makerspace-wi/Entry_System/README.md

# Entry_System
### RFID Tag controlled Entry Door Control System

Neu November 2021: RFID-Lesegerät mit Tastatur für erweiterte Sicherheit und Funktionalität

 

##### Prozessor Typ: Arduino Mini Pro 5 Volt
##### Components:
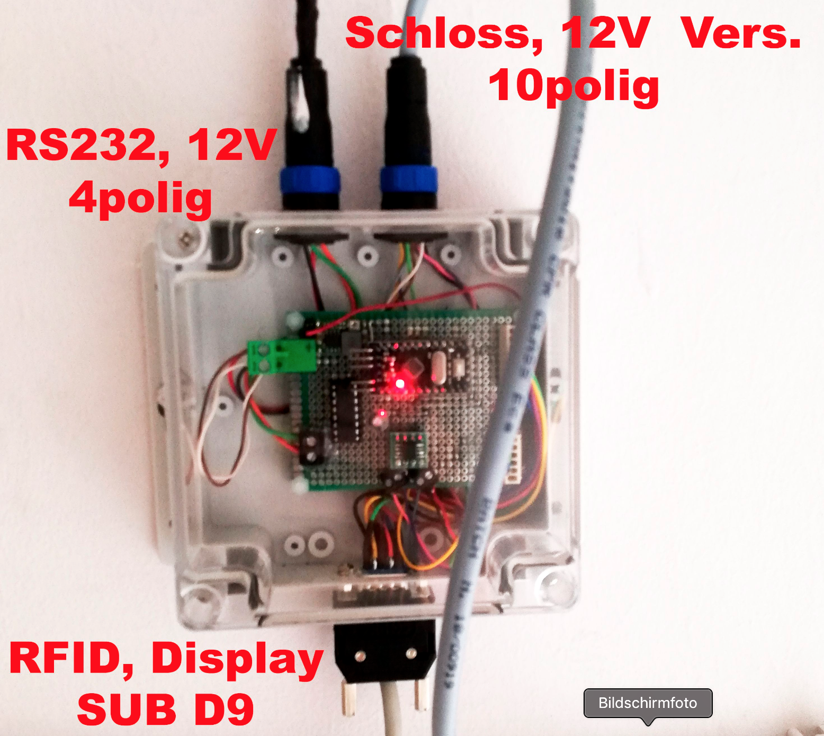
[picture p1: images/Screenshot 2018-11-06 08.17.54.png]
- Front End Controller Arduino Mini Pro<br><br> <br>
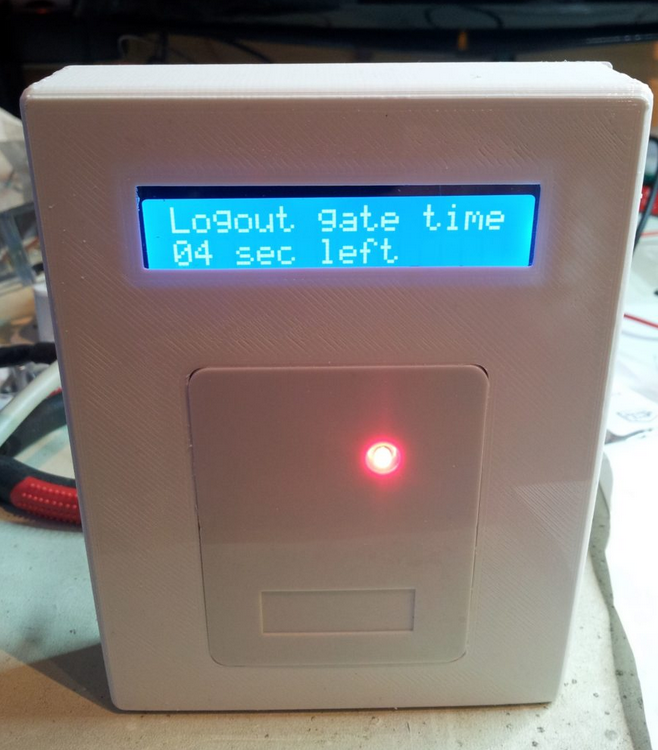
[picture p2: images/Screenshot 2018-11-06 09.19.30.png]
- RFID-Reader and Display Unit (mounted outside beside the entry door)<br><br>
- new from Nov/Dec 2021 on:<br>
<br> <br>
- 12 VDC power supply with rechargeable battery (12V 20Ah)
- Raspberry Pi 3 located in Server room - connected via serial link <br>running SYMCON Automation Software & MySQL Databse
- KESO MOZY eco (Motorzylinder) 12VDC

##### Output Signals:
- unlock KESO Motorzylinder pulse
- unlock KESO Motorzylinder permanantely
- I2C Signal to Display Unit

##### Input Signals:
- Wiegand Bus (D0 & D1) from RFID-Card reader
- KESO MOZY 'UNLOCK' signal
- 'ring' signal from Siedle Door Station
