makerspace-wi/Entry_System/doc/GeräteListe.pdf

Geräte | | fertig | | | | | RFID | Controller | | Netzteil
CNC1 [Klaus] | MA01 | Ja | Ja | 9.8.1 | ≥15,00mm | xBee | RC522 | mini | flow | 1PH
CNC3 [Klaus, …] | MA02 | Ja | - | 9.8.5 | ≥15,00mm | xBee | RC523 | mini | Ja | 1PH
Laserengraver | MA03 | Ja | Ja | 9.6.x | ≥12,00mm | xBee | RC522 | mini | nein | 1PH
CNC2 Hacks, CNC14 [Michael] | MA04 | Ja | Ja | 9.6.x | ≥12,00mm | xBee | RC522 | mini | (Ja) | 1PH
Kappsäge Holz | MA05 | Ja | Ja | 9.8.1 | ≥12,00mm | xBee | RC522 | mini | ja | 1PH
Formatkreissäge Holz | MA06 | Ja | Ja | 9.8.1 | ≥15,00mm | xBee | RC522 | mini | ja | 3PH
Bandsäge Holz | MA07 | Ja | Ja | 9.8.1 | ≥15,00mm | xBee | RC522 | mini | ja | 3PH
Dickenhobel Holz | MA08 | Ja | Ja | 8.8.1 | ≥15,00mm | xBee | RC522 | mini | ja | 3PH
Schleifer Holz | MA09 | Ja | Ja | 9.8.1 | ≥15,00mm | xBee | RC522 | mini | ja | 3PH
Blauer Laser | MA10 | Ja | Ja | 9.6.x | ≥5,00mm | xBee | RC522 | mini | (Ja) | 1PH
Drechselbank 1 | MA11 | Ja | Ja | 9.8.1 | ≥12,00mm | xBee | RC522 | mini | nein | 1PH
Drechselbank 2 | MA12 | Ja | Ja | 9.8.1 | ≥15,00mm | xBee | RC522 | mini | nein | 1PH
Kappsäge Metall | MA13 | Ja | Ja | 9.7.3 | ≥15,00mm | xBee | RC522 | mini | nein | 1PH
Frästisch Holz | MA14 | Ja | Ja | 9.6.x | ≥12,00mm | xBee | RC522 | mini | ja | 1PH
Drehbank Metall | MA15 | Ja | Ja | 9.6.x | ≥12,00mm | xBee | RC522 | mini | nein | 3PH
Ständerbohrmaschine Metall | MA16 | Ja | Ja | 9.8.1 | ≥15,00mm | xBee | RC522 | mini | nein | 1PH
Dekupiersäge | MA17 | Ja | Ja | 9.8.1 | ≥15,00mm | xBee | RC522 | mini | nein | 1PH
Sandstrahl Kompessor | MA18 | Ja | Ja | 9.8.1 | ≥15,00mm | xBee | RC522 | mini | ja | 3PH
Drehbank Üben | MA19 | Ja | Ja | 9.8.1 | ≥15,00mm | xBee | RC523 | mini | nein | 1PH
3D-Druck 1 | MA20 | - | - | 9.8.5 | ≥15,00mm | xBee | RC524 | mini | nein | 1PH | SSR
3D-Druck 2 | MA21 | - | - | 9.8.5 | ≥15,00mm | xBee | RC524 | mini | nein | 1PH | SSR
ToolsLocker1 | TOL1 | Ja | Ja | 1.0.0 | ≥20,00mm | xBee | RC522 | mini | nein | 1PH | SSR
ToolsLocker2 | TOL2 | Ja | Ja | 1.2.0 | ≥15,00mm | xBee | RC522 | mini | nein | 1PH | SSR
Garage | GADO | Ja | Ja | 1.5.0 | ≥10,00mm | xBee | PN532 | mini | nein | 1PH | SSR

Extra Teile (EntrySystem)
Entry_System | - | Ja | Ja | 3.6.0 | - | rs232 | Wiegand | mini | - | 12V (Bat.) | -
DCDC_RS232_RASPI | - | Ja | Ja | - | - | rs232 | - | - | - | 12V (Bat.) | -
RFIDServerraum | ? | Ja | Ja | ? | - | rs232 | Wiegand | nano | - | 12V (Bat.) | -
Vereinsdisplay | DISP | Ja | Ja | 1.2.1 | - | xBee | - | mini | - | 12V→24V | -
PrecenseDetector_Clock | SENSOR | Ja | Ja | 1.2.0 | - | xBee | - | mini | - | 1PH | -
Heizung | | Ja | Ja | ? | - | WLAN | - | ESP8266 | - | 5V St.NT | -
BewegungFlur | | Ja | Ja | ? | - | WLAN | - | ESP8266 | - | 5V St.NT | -
KlingelLight | | Ja | Ja | ? | - | WLAN | - | ESP8266 | - | 5V St.NT | -
Metallraum BewKliTemp | | Ja | Ja | ? | - | WLAN | - | ESP8266 | - | 5V St.NT | -
Gesamt Ja | | 31 | 30 | | Abst.: 22 | xBee: 29 | RFID: 21 | Mini: 31 | Strom=9 | 1PH=20 | SSR=18
Gesamt in Arbeit
| | | | | | WLan: 4 | WieG: 2 | Nano: 1 | flow=1 | 3PH=6 | REL=5
Maschinen-Nr. | In BetriebSoftwareVersionRFID AbstandKommuni-Kation | Strom-Messung | SSR, Relais
| | | SSR SSR SSR SSR Relais SSR SSR SSR SSR SSR SSR Relais Relais Relais Schütz Relais SSR Schütz SSR
