makerspace-wi/Entry_System/doc/Anschluss Display.jpg

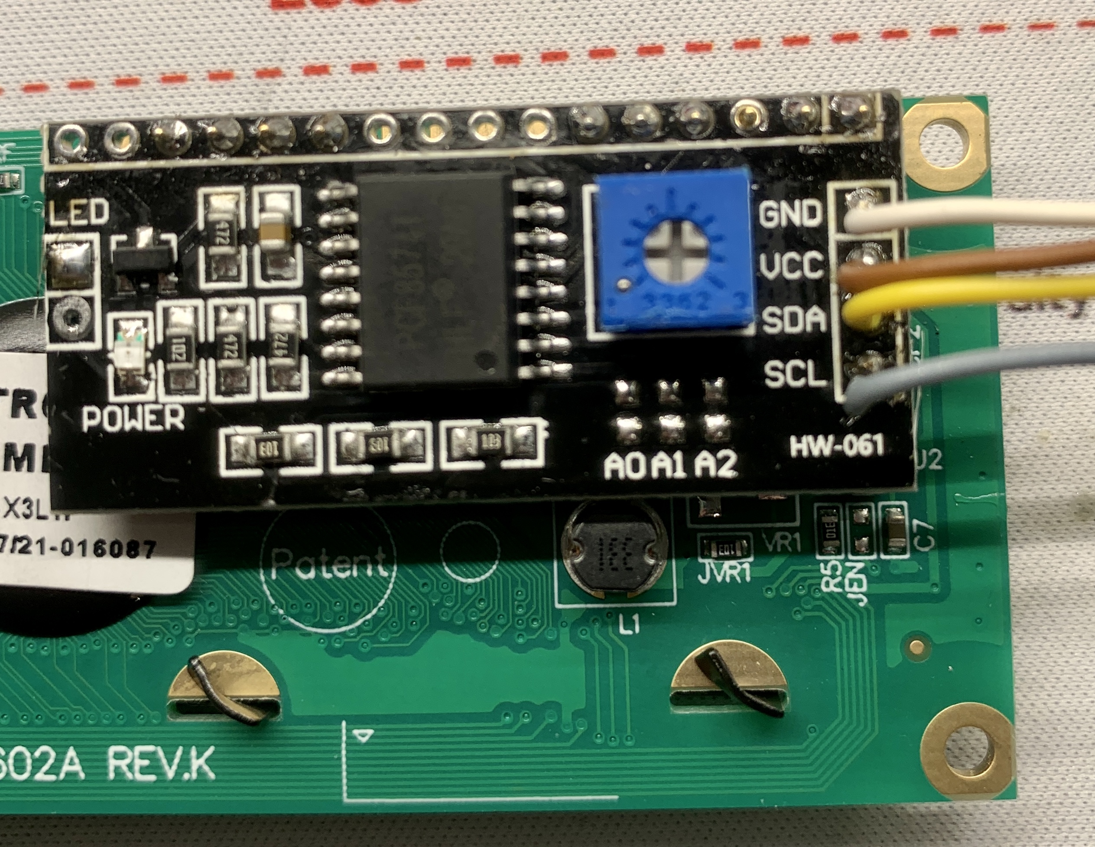
doc/Anschluss Display.jpg
