makerspace-wi/Entry_System/doc/Anschluss New Reader.jpg

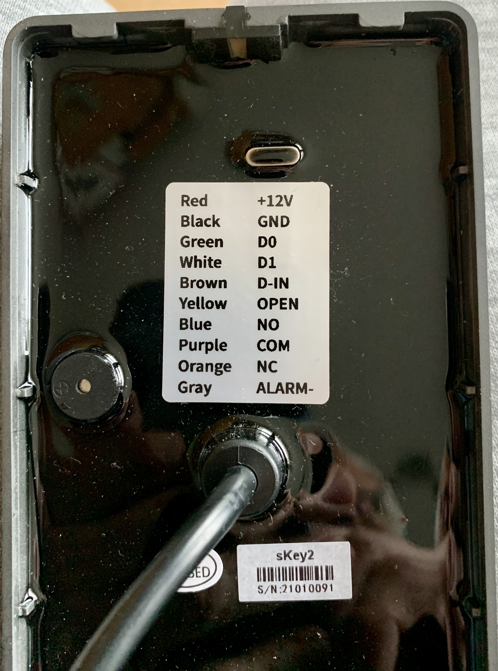
doc/Anschluss New Reader.jpg
