makerspace-wi/Entry_System/doc/GeräteListe.xls

Geräte | Maschinen- Nr. | fertig | In Betrieb | Software Version | RFID Abstand | Kommuni- Kation | RFID | Controller | Strom- Messung | Netzteil | SSR, Relais | ist vorhanden (komplett für PCBs) |  |  |  |  |  |  |  |  |  |  |  | Bemerkung |  | Preise
 |  |  |  |  |  |  |  |  |  |  |  | PCB Display | Relais | Display | RFID | Taster LED | PCB Controller | xBee | Taster RES | Gehäuse | PCB Netzteil | Netzteil | Gehäuse |  |  | RFID | NT | Summe | Erhalten
CNC1 [Klaus] | MA01 | Ja | Ja | 9.8.1 | ≥15.00mm | xBee | RC522 | mini | flow | 1PH | SSR | ok | - | ok | ok | ok | ok | ok | - | - | ok | ok | - | Ja | =nötig oder vorhanden | #REF! | #REF! | #REF!
CNC3 [Klaus, …] | MA02 | Ja | - | 9.8.5 | ≥15.00mm | xBee | RC523 | mini | Ja | 1PH | SSR | ok | ok | ok | ok | ok | ok | ok | ok | ok | ok | - | -
Laserengraver | MA03 | Ja | Ja | 9.6.x | ≥12.00mm | xBee | RC522 | mini | nein | 1PH | SSR | ok | ok | ok | ok | ok | ok | ok | ok | ok | ok | ok | ok | f | =fehlt noch | #REF! | #REF! | #REF!
CNC2 Hacks, CNC14 [Michael] | MA04 | Ja | Ja | 9.6.x | ≥12.00mm | xBee | RC522 | mini | (Ja) | 1PH | SSR | ok | ok | ok | ok | ok | ok | ok | ok | ok | ok | ok | - | - | =nicht nötig oder andere Lösung | #REF! | #REF! | #REF!
Kappsäge Holz | MA05 | Ja | Ja | 9.8.1 | ≥12.00mm | xBee | RC522 | mini | ja | 1PH | Relais | ok | ok | ok | ok | ok | ok | ok | ok | ok | ok | ok | ok | OK | =fertig und zusammen gebaut | #REF! | #REF! | #REF! | 280.00 €
Formatkreissäge Holz | MA06 | Ja | Ja | 9.8.1 | ≥15.00mm | xBee | RC522 | mini | ja | 3PH | SSR | ok | ok | ok | ok | ok | ok | ok | ok | ok | ok | ok | ok |  |  | #REF! | #REF! | #REF!
Bandsäge Holz | MA07 | Ja | Ja | 9.8.1 | ≥15.00mm | xBee | RC522 | mini | ja | 3PH | SSR | ok | ok | ok | ok | ok | ok | ok | ok | ok | ok | ok | ok |  |  | #REF! | #REF! | #REF!
Dickenhobel Holz | MA08 | Ja | Ja | 8.8.1 | ≥15.00mm | xBee | RC522 | mini | ja | 3PH | SSR | ok | ok | ok | ok | ok | ok | ok | ok | ok | ok | ok | ok |  |  | #REF! | #REF! | #REF! | 268.00 €
Schleifer Holz | MA09 | Ja | Ja | 9.8.1 | ≥15.00mm | xBee | RC522 | mini | ja | 3PH | SSR | ok | ok | ok | ok | ok | ok | ok | ok | ok | ok | ok | ok |  |  | #REF! | #REF! | #REF!
Blauer Laser | MA10 | Ja | Ja | 9.6.x | ≥5.00mm | xBee | RC522 | mini | (Ja) | 1PH | SSR | ok | ok | ok | ok | ok | ok | ok | ok | ok | ok | ok | ok |  |  | #REF! | #REF! | #REF! | 505.00 €
Drechselbank 1 | MA11 | Ja | Ja | 9.8.1 | ≥12.00mm | xBee | RC522 | mini | nein | 1PH | SSR | ok | ok | ok | ok | ok | ok | ok | ok | ok | ok | ok | ok |  |  | #REF! | #REF! | #REF!
Drechselbank 2 | MA12 | Ja | Ja | 9.8.1 | ≥15.00mm | xBee | RC522 | mini | nein | 1PH | Relais | ok | ok | ok | ok | ok | ok | ok | ok | ok | ok | ok | ok |  |  | #REF! | #REF! | #REF!
Kappsäge Metall | MA13 | Ja | Ja | 9.7.3 | ≥15.00mm | xBee | RC522 | mini | nein | 1PH | Relais | ok | ok | ok | ok | ok | ok | ok | ok | ok | ok | ok | ok |  |  | #REF! | #REF! | #REF!
Frästisch Holz | MA14 | Ja | Ja | 9.6.x | ≥12.00mm | xBee | RC522 | mini | ja | 1PH | Relais | ok | ok | ok | ok | ok | ok | ok | ok | ok | ok | ok | ok |  |  | #REF! | #REF! | #REF!
Drehbank Metall | MA15 | Ja | Ja | 9.6.x | ≥12.00mm | xBee | RC522 | mini | nein | 3PH | Schütz | ok | ok | ok | ok | ok | ok | ok | ok | ok | ok | ok | ok |  |  | #REF! | #REF! | #REF!
Ständerbohrmaschine Metall | MA16 | Ja | Ja | 9.8.1 | ≥15.00mm | xBee | RC522 | mini | nein | 1PH | Relais | ok | ok | ok | ok | ok | ok | ok | ok | ok | ok | ok | - |  |  | #REF! | #REF! | #REF!
Dekupiersäge | MA17 | Ja | Ja | 9.8.1 | ≥15.00mm | xBee | RC522 | mini | nein | 1PH | SSR | ok | ok | ok | ok | ok | ok | ok | ok | ok | ok | ok | ok
Sandstrahl Kompessor | MA18 | Ja | Ja | 9.8.1 | ≥15.00mm | xBee | RC522 | mini | ja | 3PH | Schütz | ok | ok | ok | ok | ok | ok | ok | ok | ok | ok | ok | ok
Drehbank Üben | MA19 | Ja | Ja | 9.8.1 | ≥15.00mm | xBee | RC523 | mini | nein | 1PH | SSR | ok | ok | ok | ok | ok | ok | ok | ok | ok | ok | ok | ok
3D-Druck 1 | MA20 | - | - | 9.8.5 | ≥15.00mm | xBee | RC524 | mini | nein | 1PH | SSR | ok | ok | ok | ok | ok | ok | ok | ok | ok | ok | - | -
3D-Druck 2 | MA21 | - | - | 9.8.5 | ≥15.00mm | xBee | RC524 | mini | nein | 1PH | SSR | ok | ok | ??? | ok | ok | ok | ??? | ok | ok | ok | - | - |  |  | #REF! | ? | #REF!
ToolsLocker1 | TOL1 | Ja | Ja | 1.0.0 | ≥20.00mm | xBee | RC522 | mini | nein | 1PH | SSR | ok | ok | ok | ok | ok | ok | ok | ok | ok | ok | ok | - |  |  | #REF! | ? | #REF!
ToolsLocker2 | TOL2 | Ja | Ja | 1.2.0 | ≥15.00mm | xBee | RC522 | mini | nein | 1PH | SSR | ok | ok | ok | ok | ok | ok | ok | ok | ok | ok | ok | -
Garage | GADO | Ja | Ja | 1.5.0 | ≥10.00mm | xBee | PN532 | mini | nein | 1PH | SSR | ok | ok | ok | ok | ok | ok | ok | ok | f | ok | ok | -
Extra Teile (EntrySystem)
Entry_System | - | Ja | Ja | 3.6.0 | - | rs232 | Wiegand | mini | - | 12V (Bat.) | - |  |  |  |  |  |  |  |  | ok
DCDC_RS232_RASPI | - | Ja | Ja | - | - | rs232 | - | - | - | 12V (Bat.) | -
RFIDServerraum | ? | Ja | Ja | ? | - | rs232 | Wiegand | nano | - | 12V (Bat.) | - |  |  |  |  |  |  |  |  | ok
Vereinsdisplay | DISP | Ja | Ja | 1.2.1 | - | xBee | - | mini | - | 12V→24V | - |  |  |  |  |  | ok | ok |  |  | ok | Step U&D
PrecenseDetector_Clock | SENSOR | Ja | Ja | 1.2.0 | - | xBee | - | mini | - | 1PH | - |  |  |  |  |  | ok | ok |  | ok |  | Step D | -
Heizung |  | Ja | Ja | ? | - | WLAN | - | ESP8266 | - | 5V St.NT | -
BewegungFlur |  | Ja | Ja | ? | - | WLAN | - | ESP8266 | - | 5V St.NT | -
KlingelLight |  | Ja | Ja | ? | - | WLAN | - | ESP8266 | - | 5V St.NT | -
Metallraum BewKliTemp |  | Ja | Ja | ? | - | WLAN | - | ESP8266 | - | 5V St.NT | -
Gesamt Ja |  | 31 | 30 |  | 0 | 0 | 0 | 0 | 0 | 0 | 0 | 0 | 0 | 0 | 0 |  | 0 | 0 |  | 0 | 0 | 0 | 0
Gesamt in Arbeit | ab Spalte M |  |  |  |  | 0 | 0 | 0 | 0 | 0 | 0 | 0 | 0 | 0 | 0 |  | 0 | 0 |  | 0 | 0 | 0 | 0 |  |  |  |  | #N/A | 1053.00 €
Gesamt unterwegs |  |  |  |  |  | 0 |  | 0 |  | 0 | 0 | 0 | 0 | 0 | 0 |  | 0 | 0 |  | 1 | 0 | 0 | 0 |  |  |  |  | #REF!
Gesamt fertig |  |  |  |  |  |  |  |  |  | 0 |  | 25 | 24 | 23 | 25 |  | 27 | 25 |  | 26 | 26 | 21 | 15 |  |  |  |  | #REF!
