makerspace-wi/Entry_System/doc/Controller_Absaugung.pdf

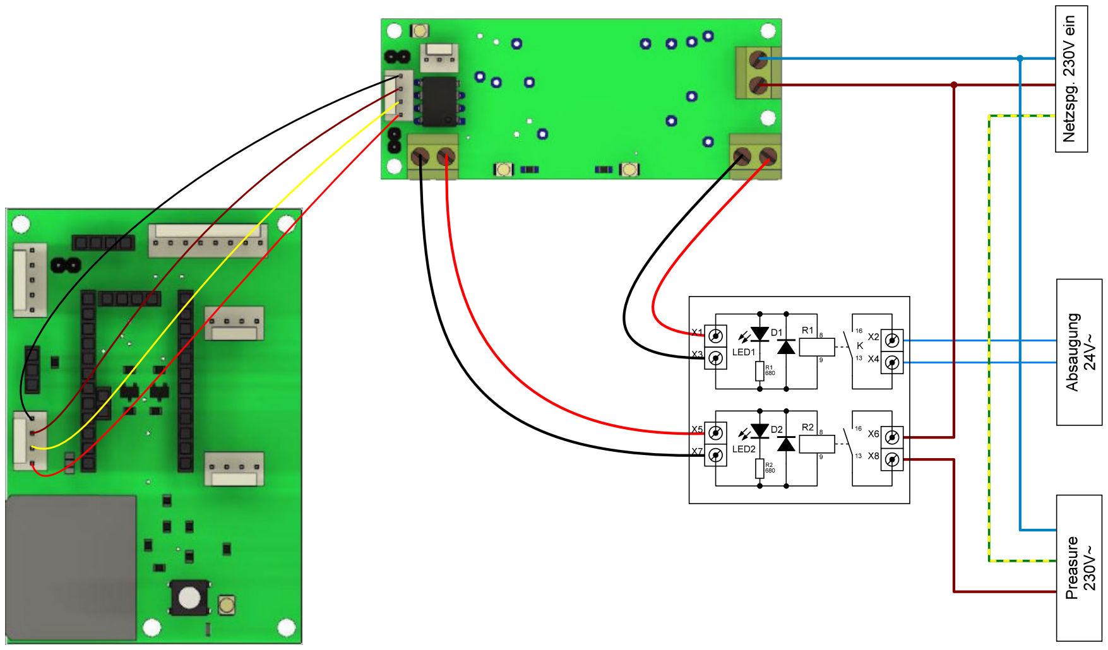
[picture p5: page 1]

0 10

0

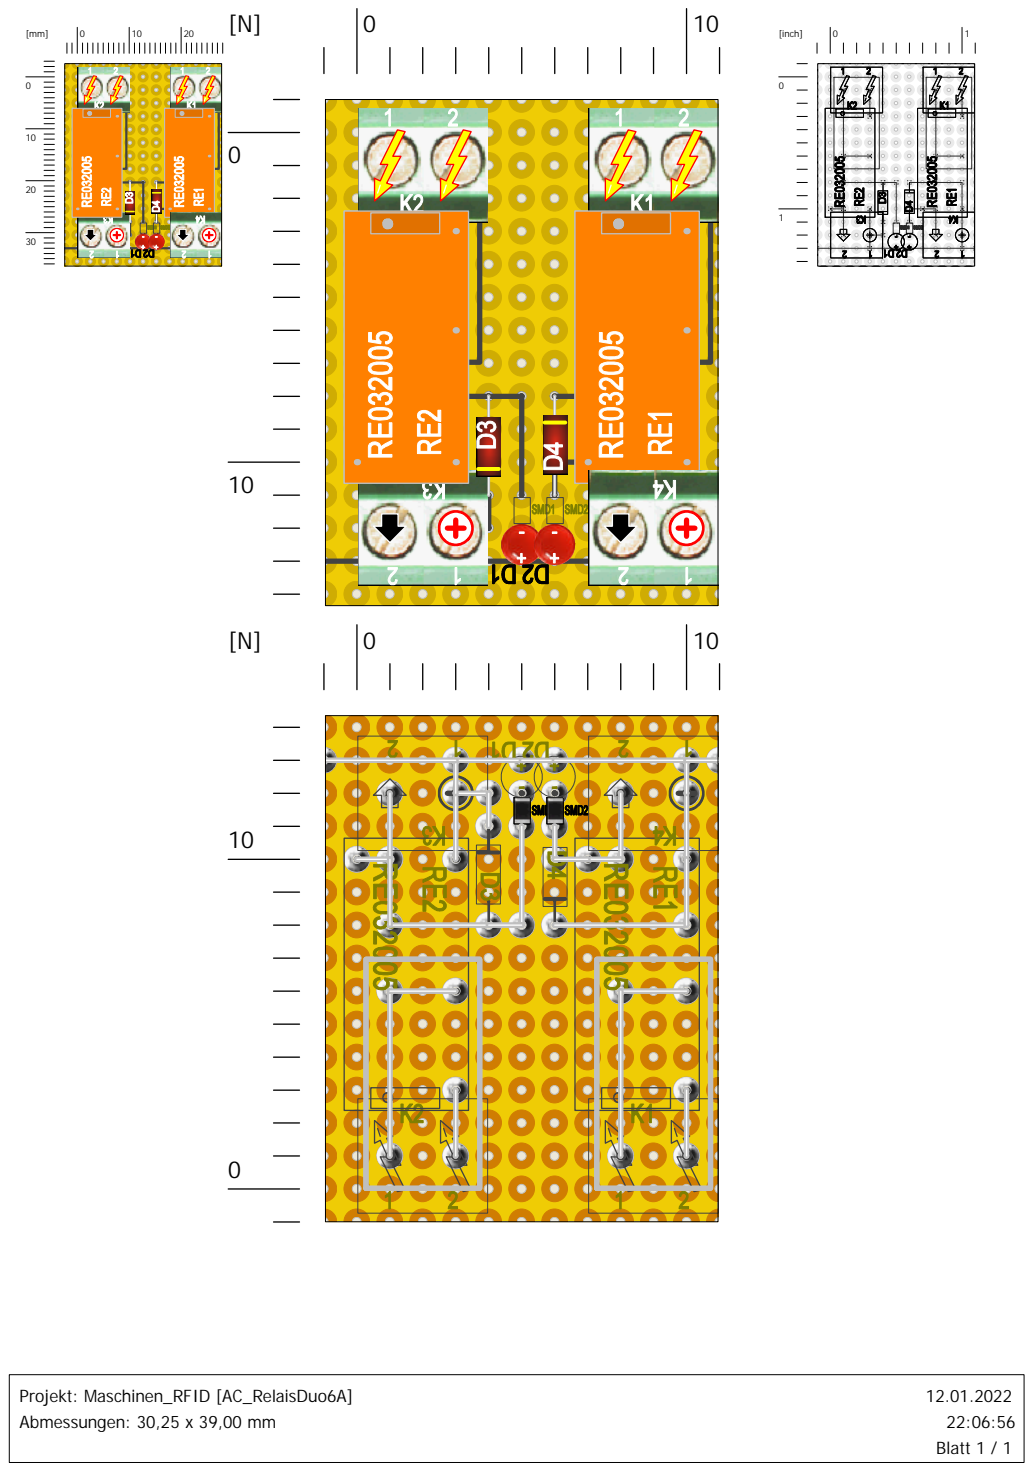
[picture p6: page 2]
[inch]; Projekt: Maschinen_RFID [AC_RelaisDuo6A] Abmessungen: 30,25 x 39,00 mm; 12.01.2022 22:06:56 Blatt 1 / 1
