makerspace-wi/Entry_System/doc/Maschinen_RFID_Versorgung_MV.pdf

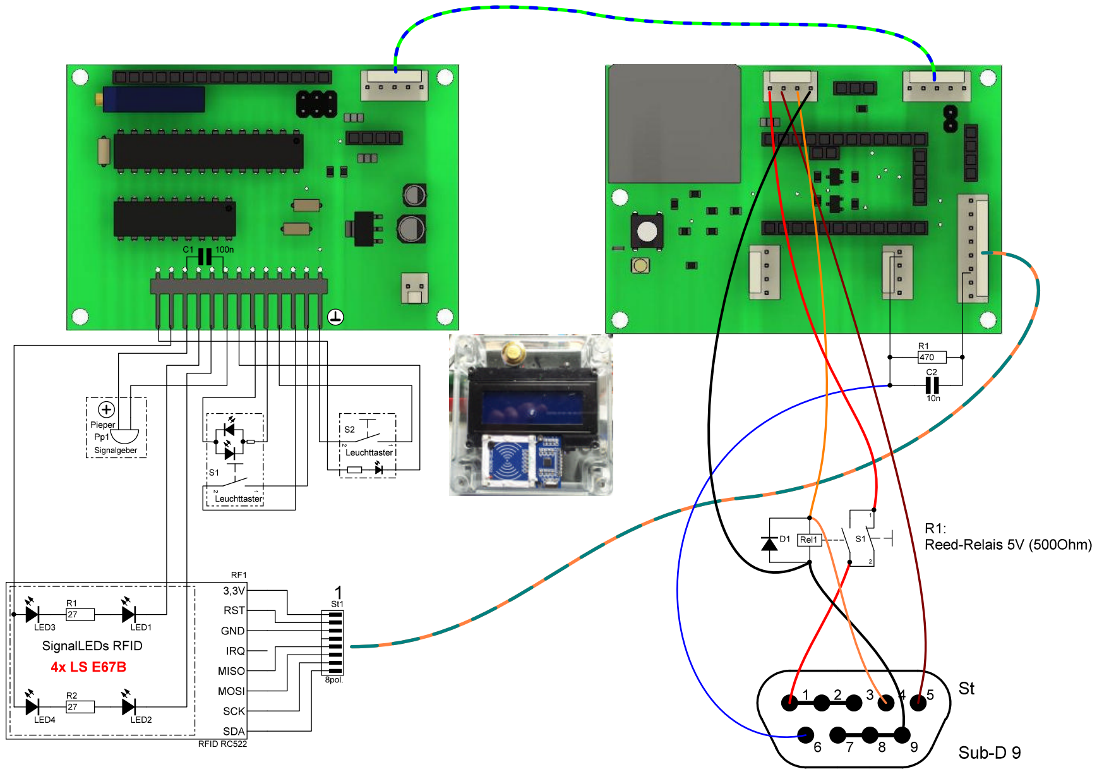
[picture p7: page 1]

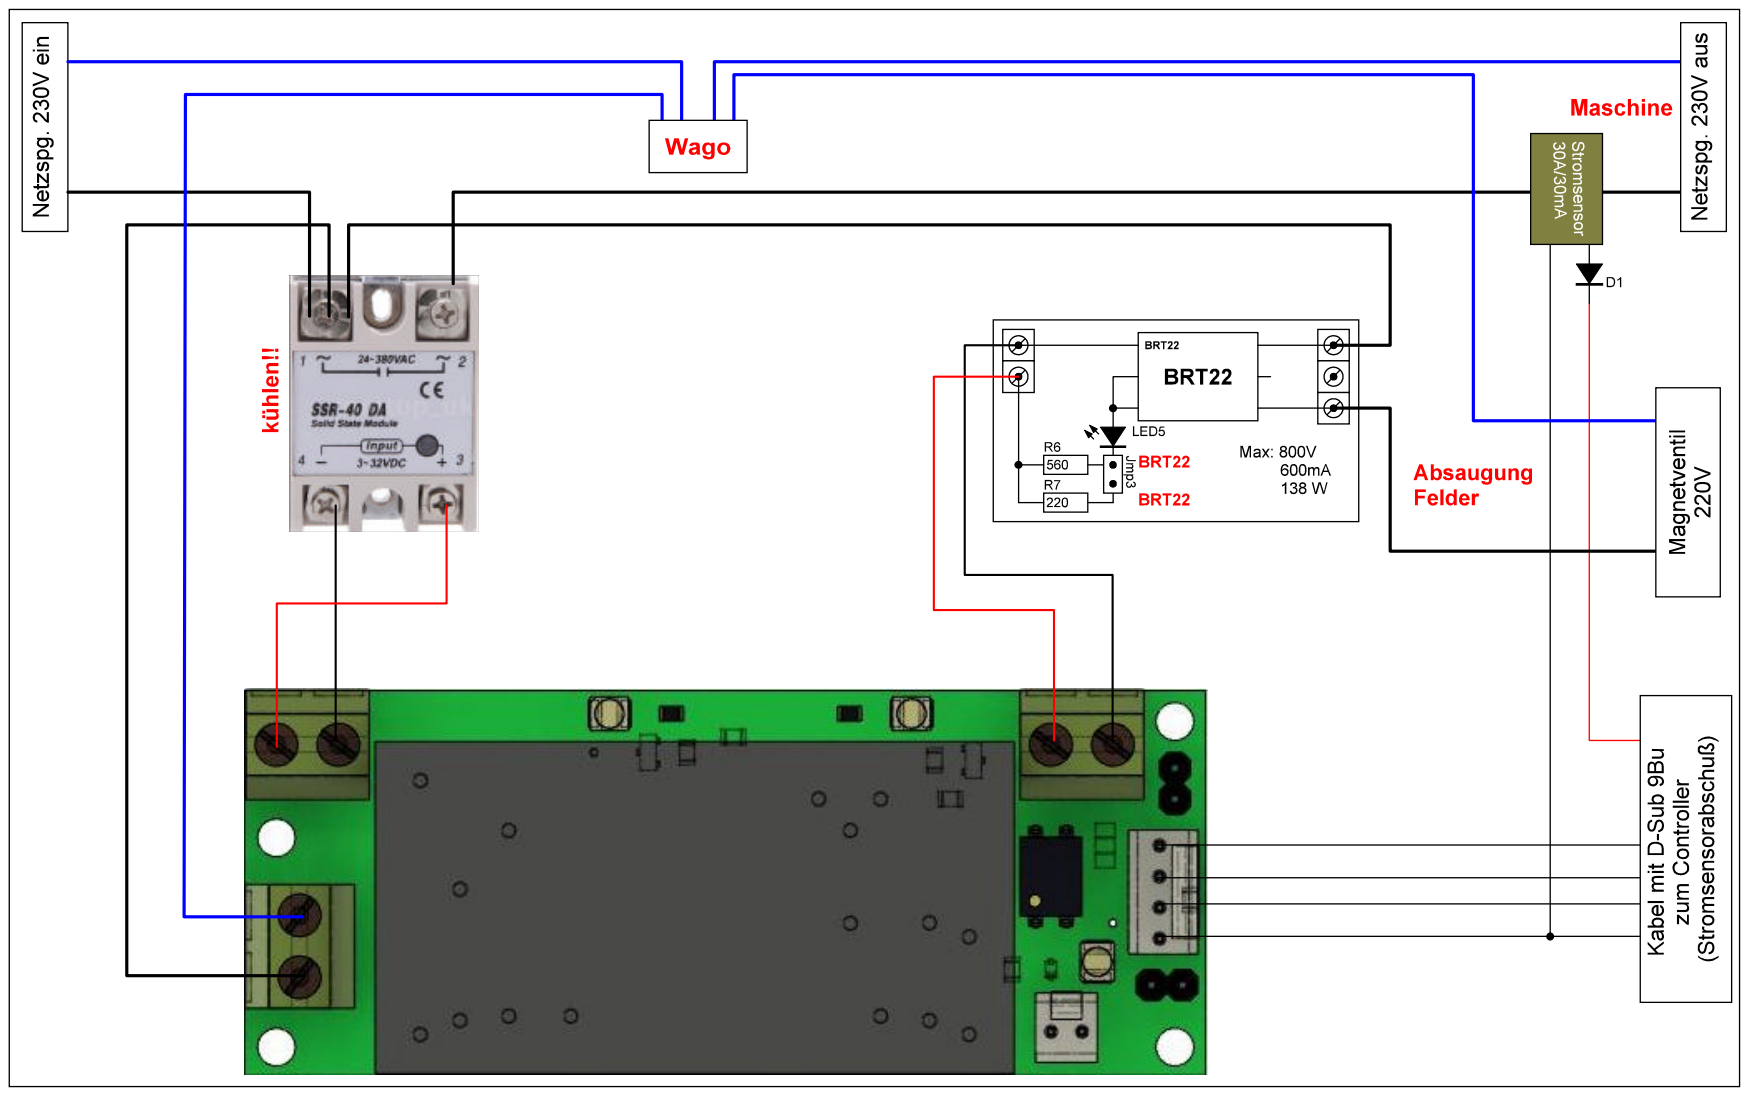
[picture p8: page 2]

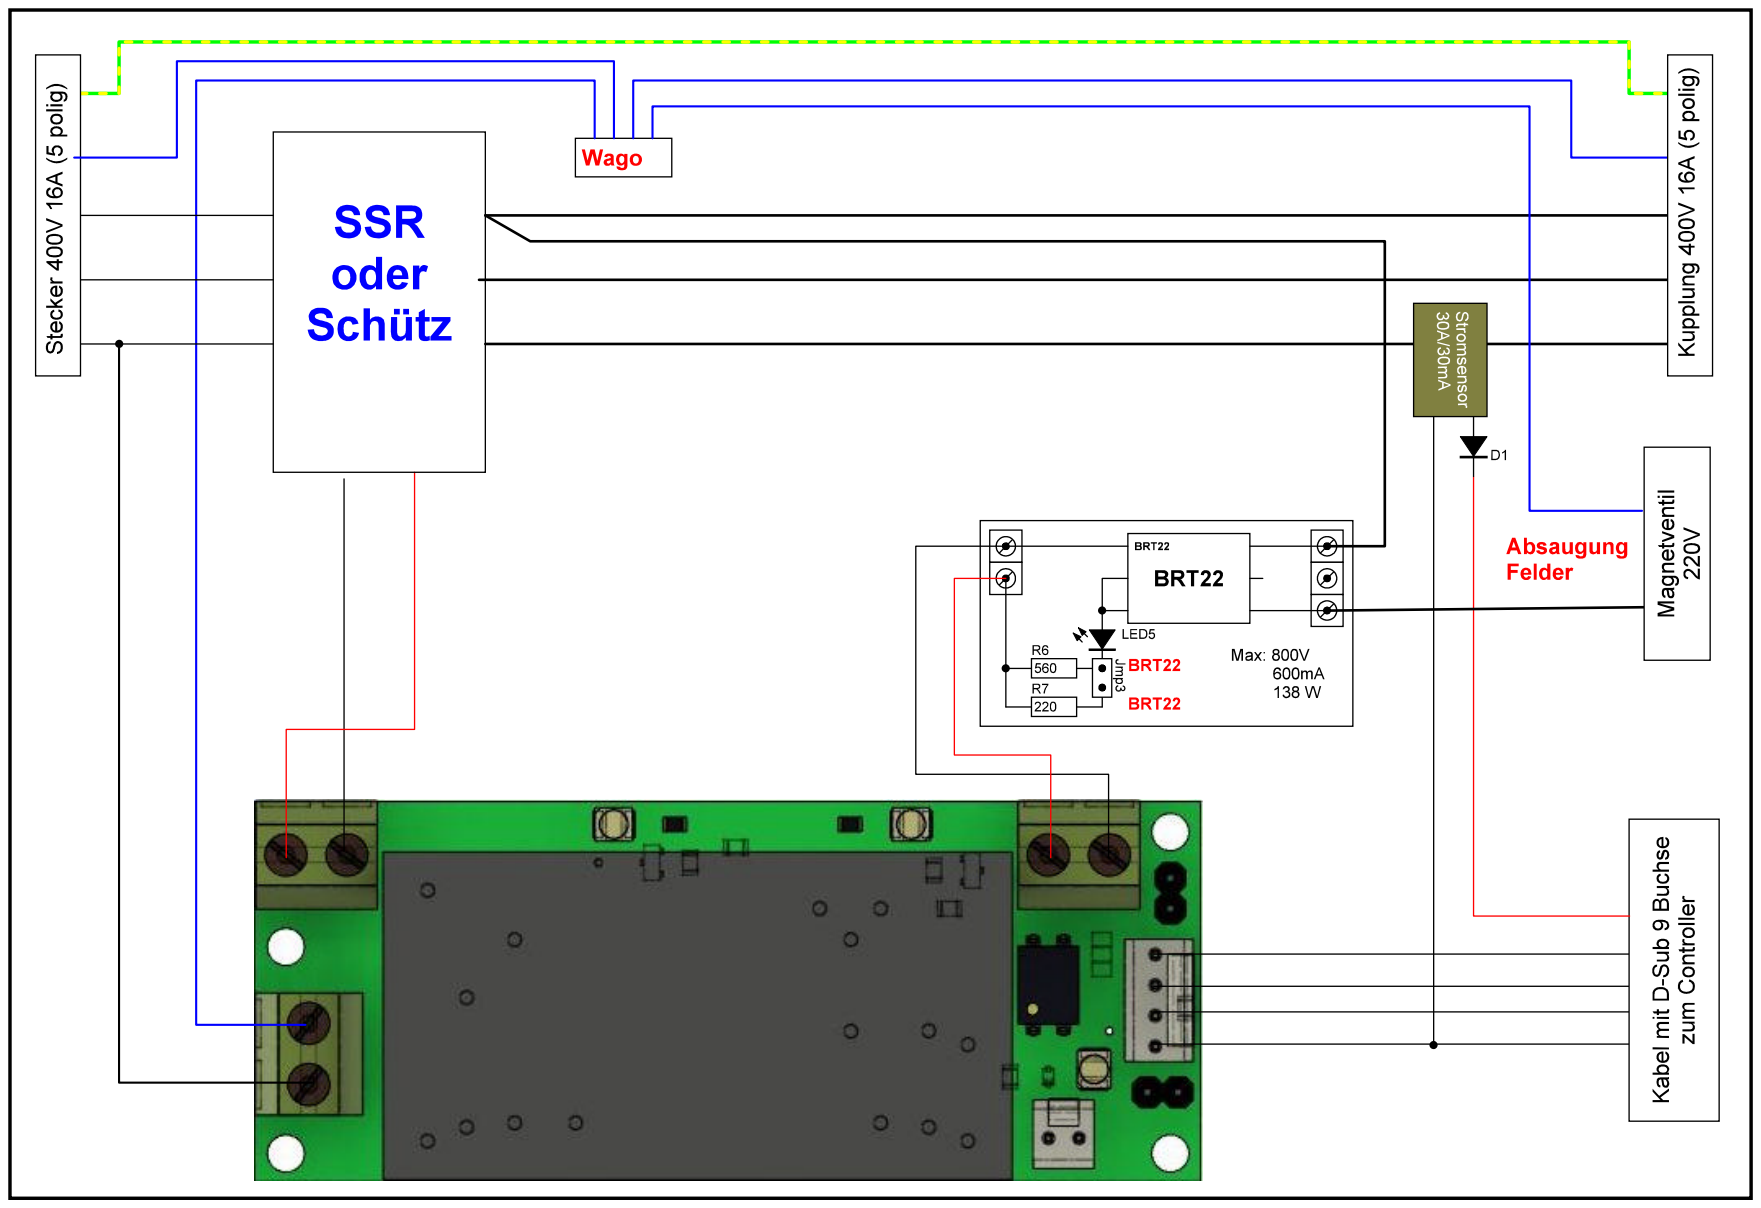
[picture p9: page 3]

0

0

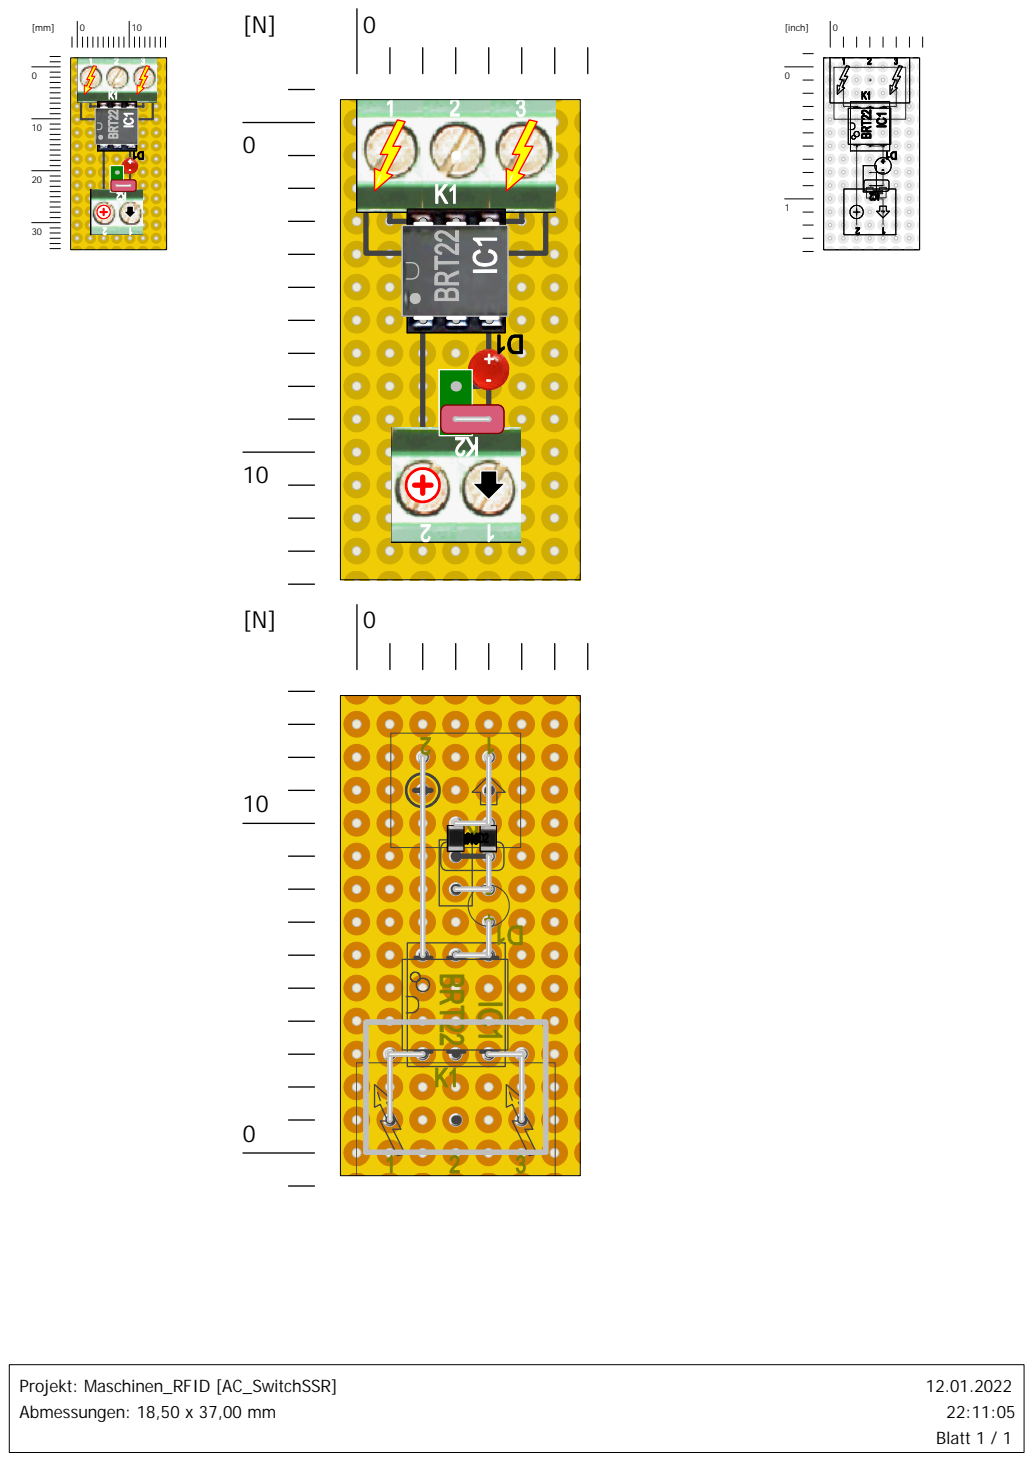
[picture p10: page 4]
[inch]; Projekt: Maschinen_RFID [AC_SwitchSSR] Abmessungen: 18,50 x 37,00 mm; 12.01.2022 22:11:05 Blatt 1 / 1
