makerspace-wi/Entry_System/doc/Bohrplan-MaschinenNV1.pdf

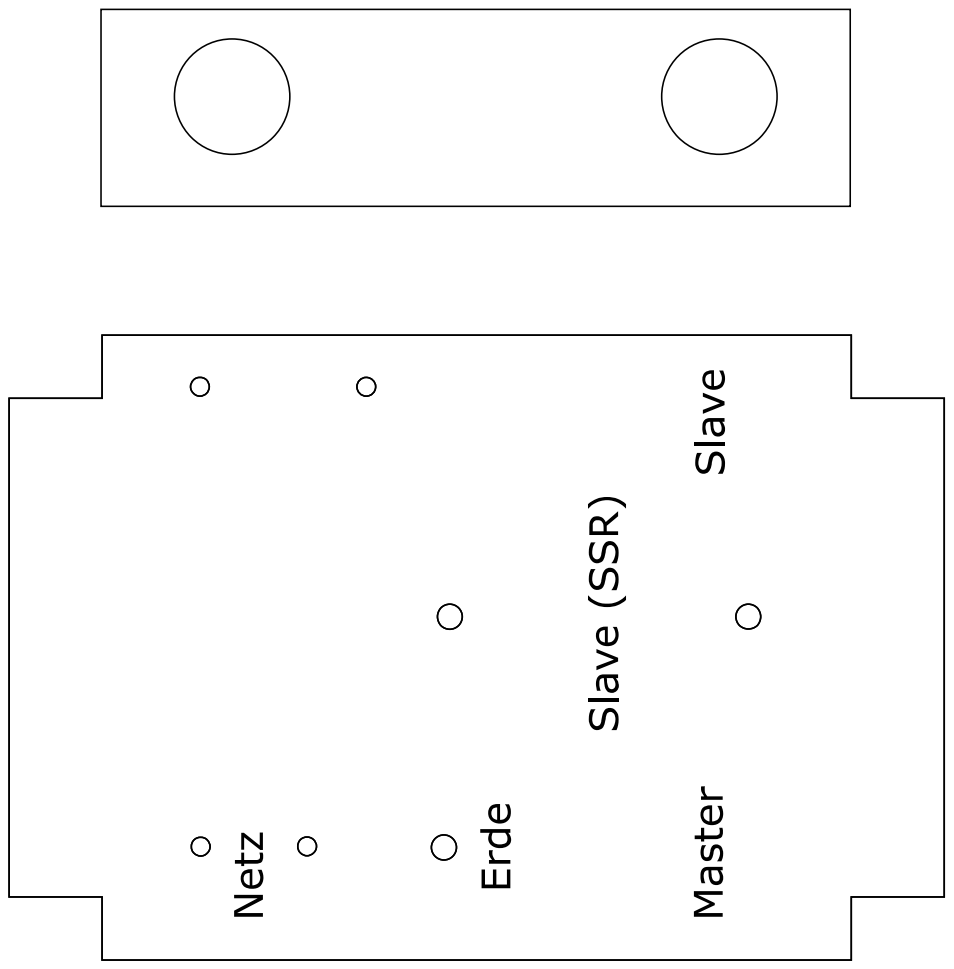
[picture p26: page 1]
