makerspace-wi/Entry_System/doc/Bohrplan-MaschinenNV2.pdf

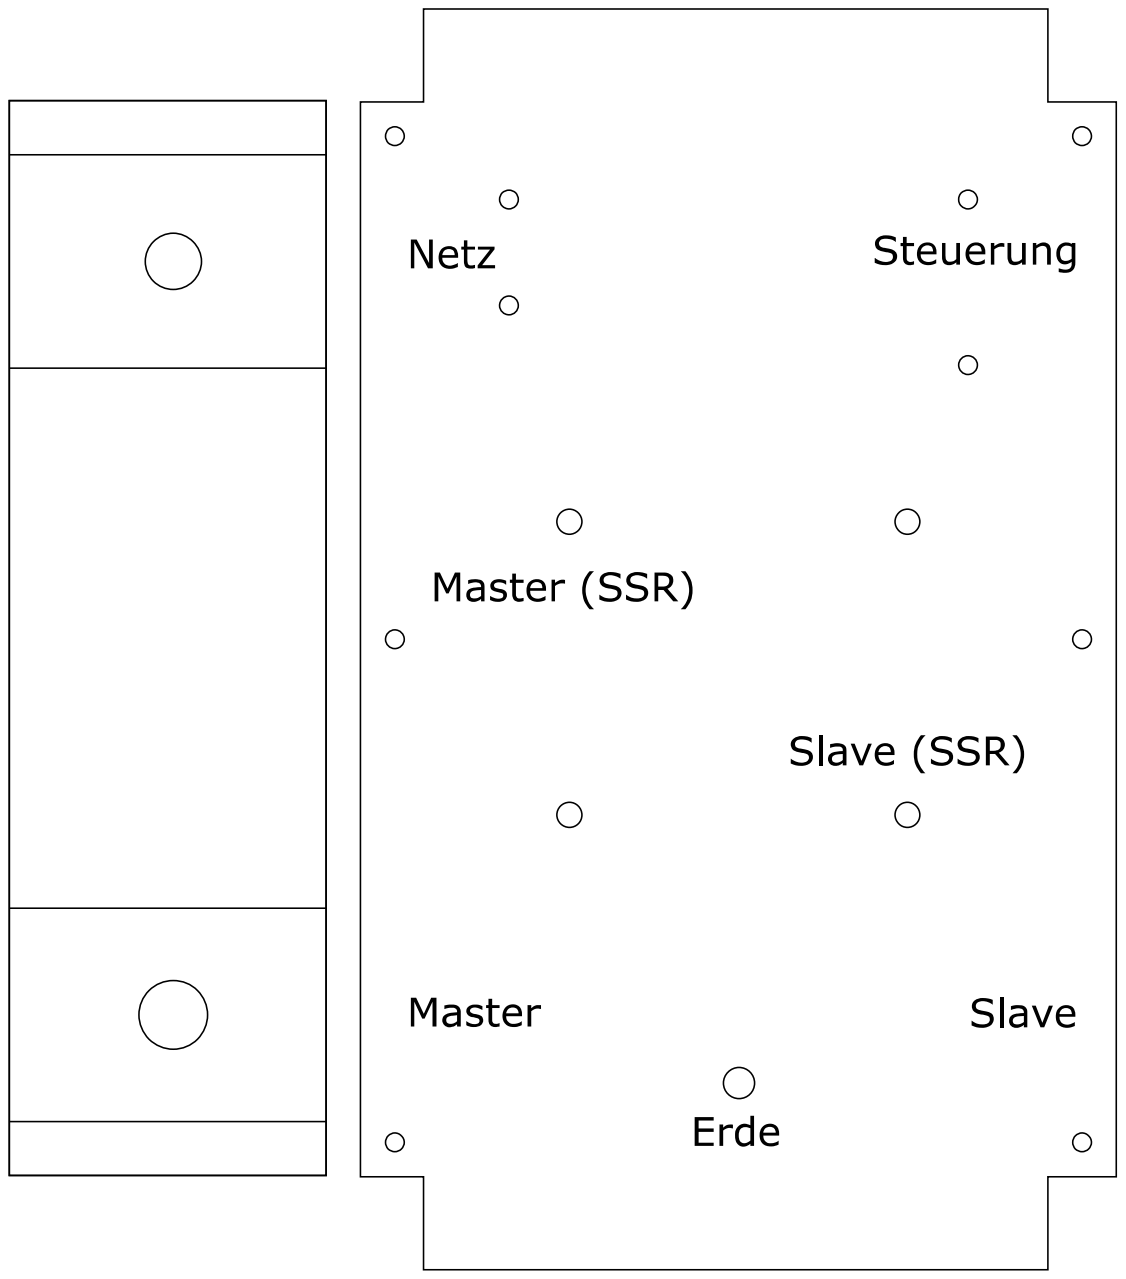
[picture p27: page 1]
