makerspace-wi/Entry_System/doc/Bohrplan-MaschinenNV3.pdf

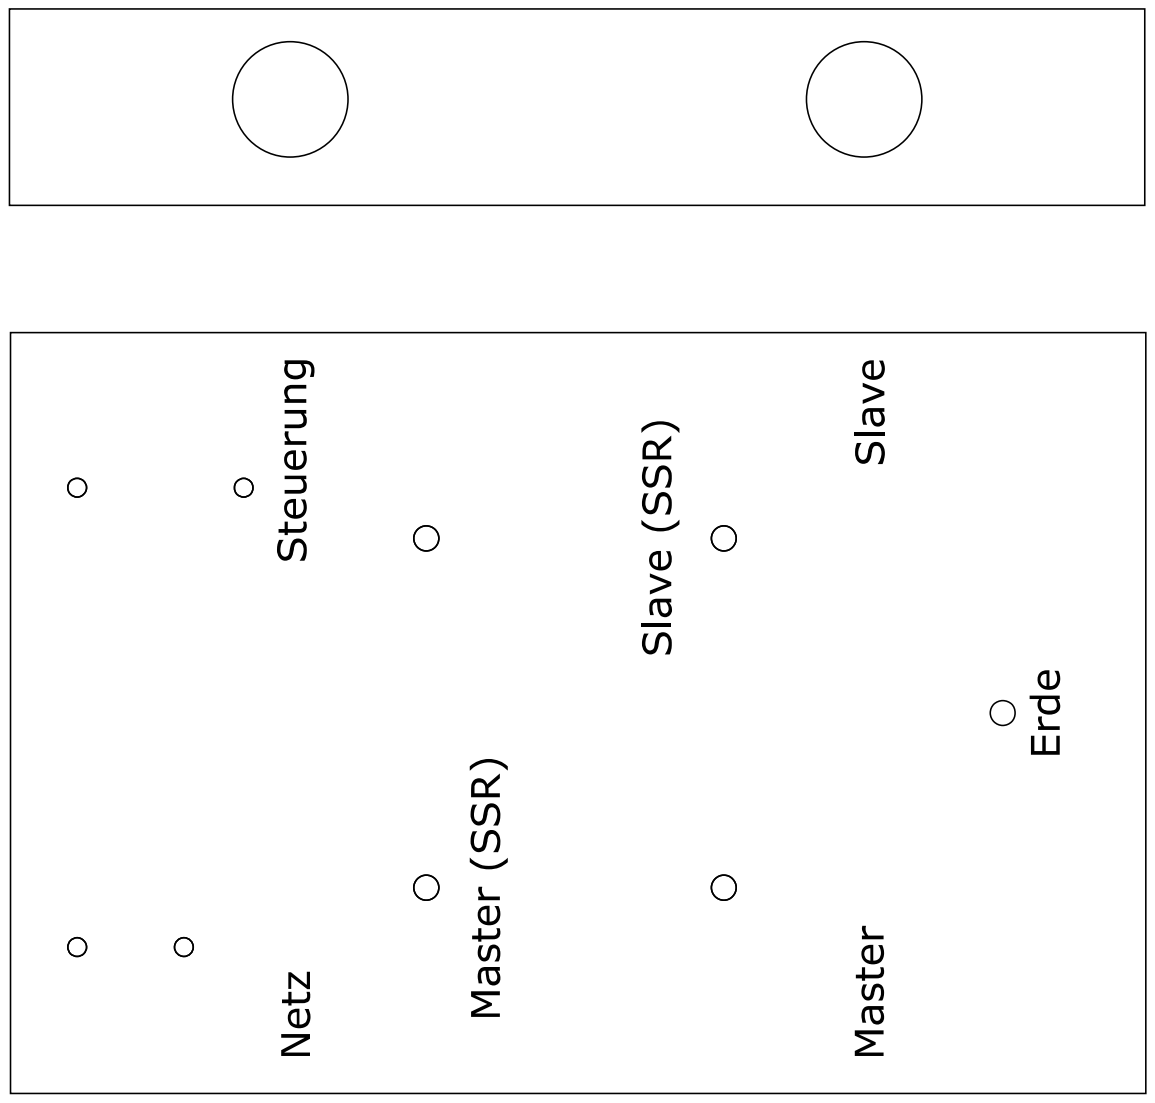
[picture p28: page 1]
