makerspace-wi/Entry_System/(commit log)

2020-01-19 Add extarnal watch dog timer
2022-11-17 add and rename document
    [GeräteListe.xls]
2024-11-05 Update Geräteliste
    [GeräteListe.xls]
